Bonaventure129/inpatient-monitoring-system/image/block diagram.png

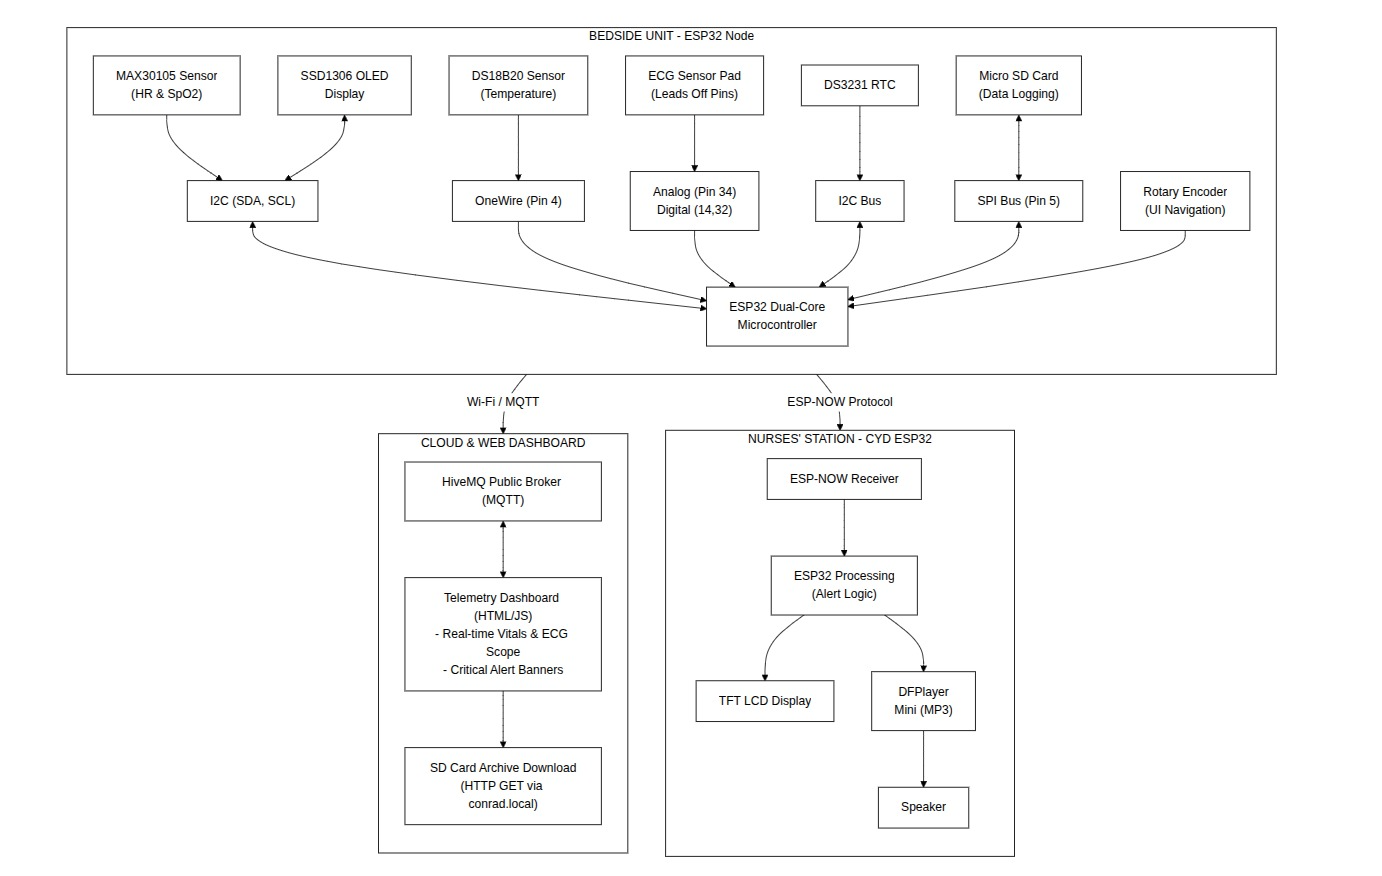
image/block diagram.png
