Bonaventure129/inpatient-monitoring-system/image/flowchart.png

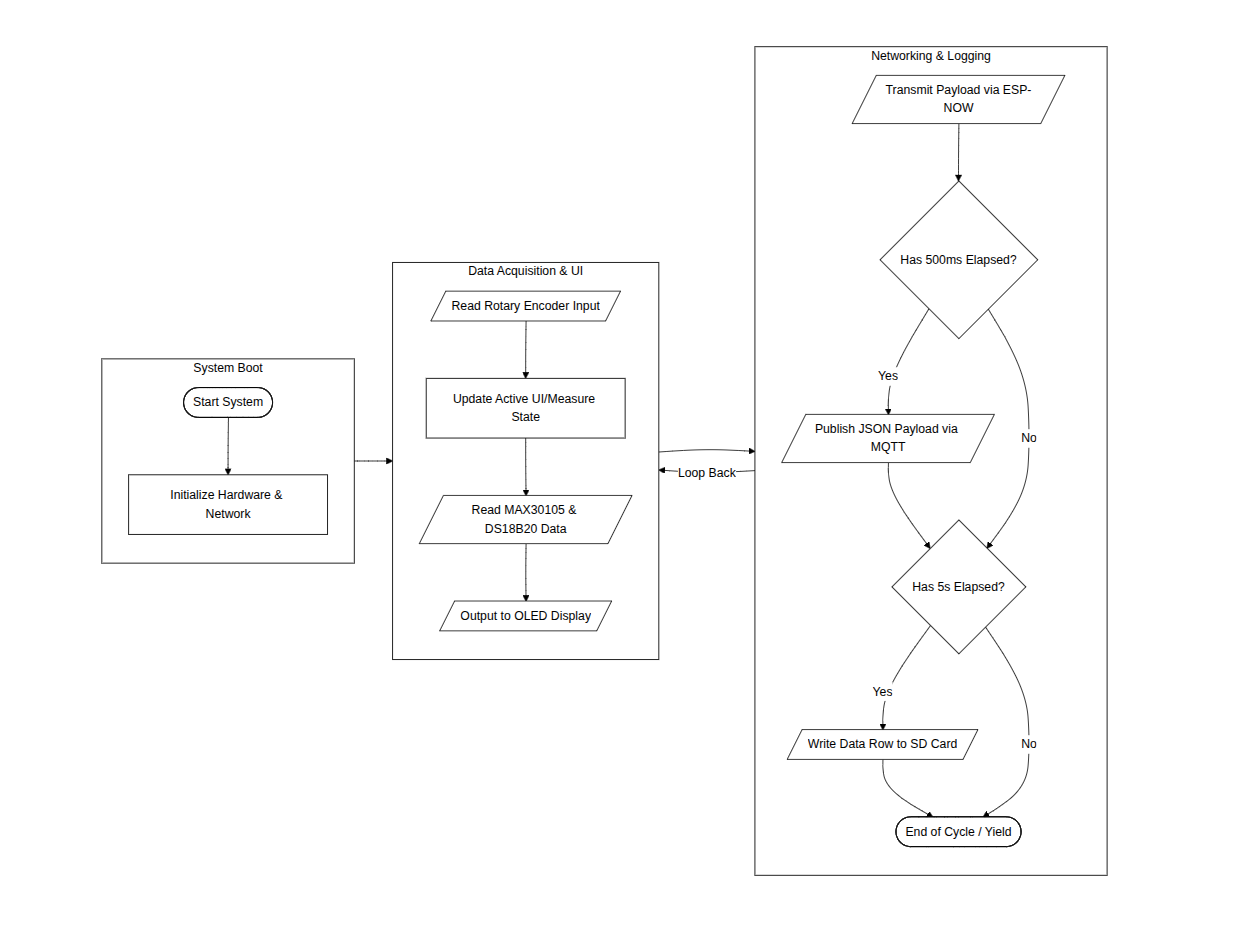
image/flowchart.png
