Bonaventure129/inpatient-monitoring-system/image/Schematic_Inpatient-monitoring-system-schematics_2026-08-19.png

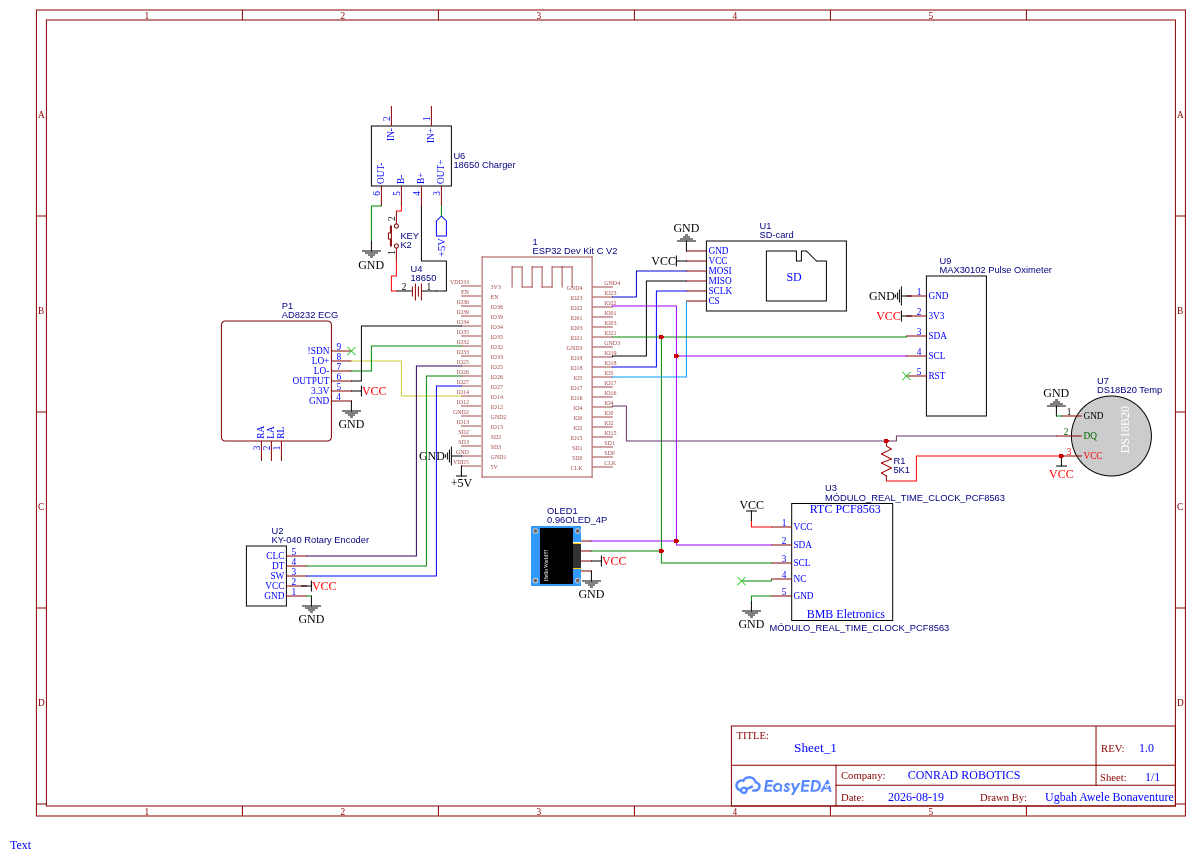
image/Schematic_Inpatient-monitoring-system-schematics_2026-08-19.png
