Bonaventure129/inpatient-monitoring-system/image/patient ward Inpatient -monitoring system schematics.pdf

SD

### GND

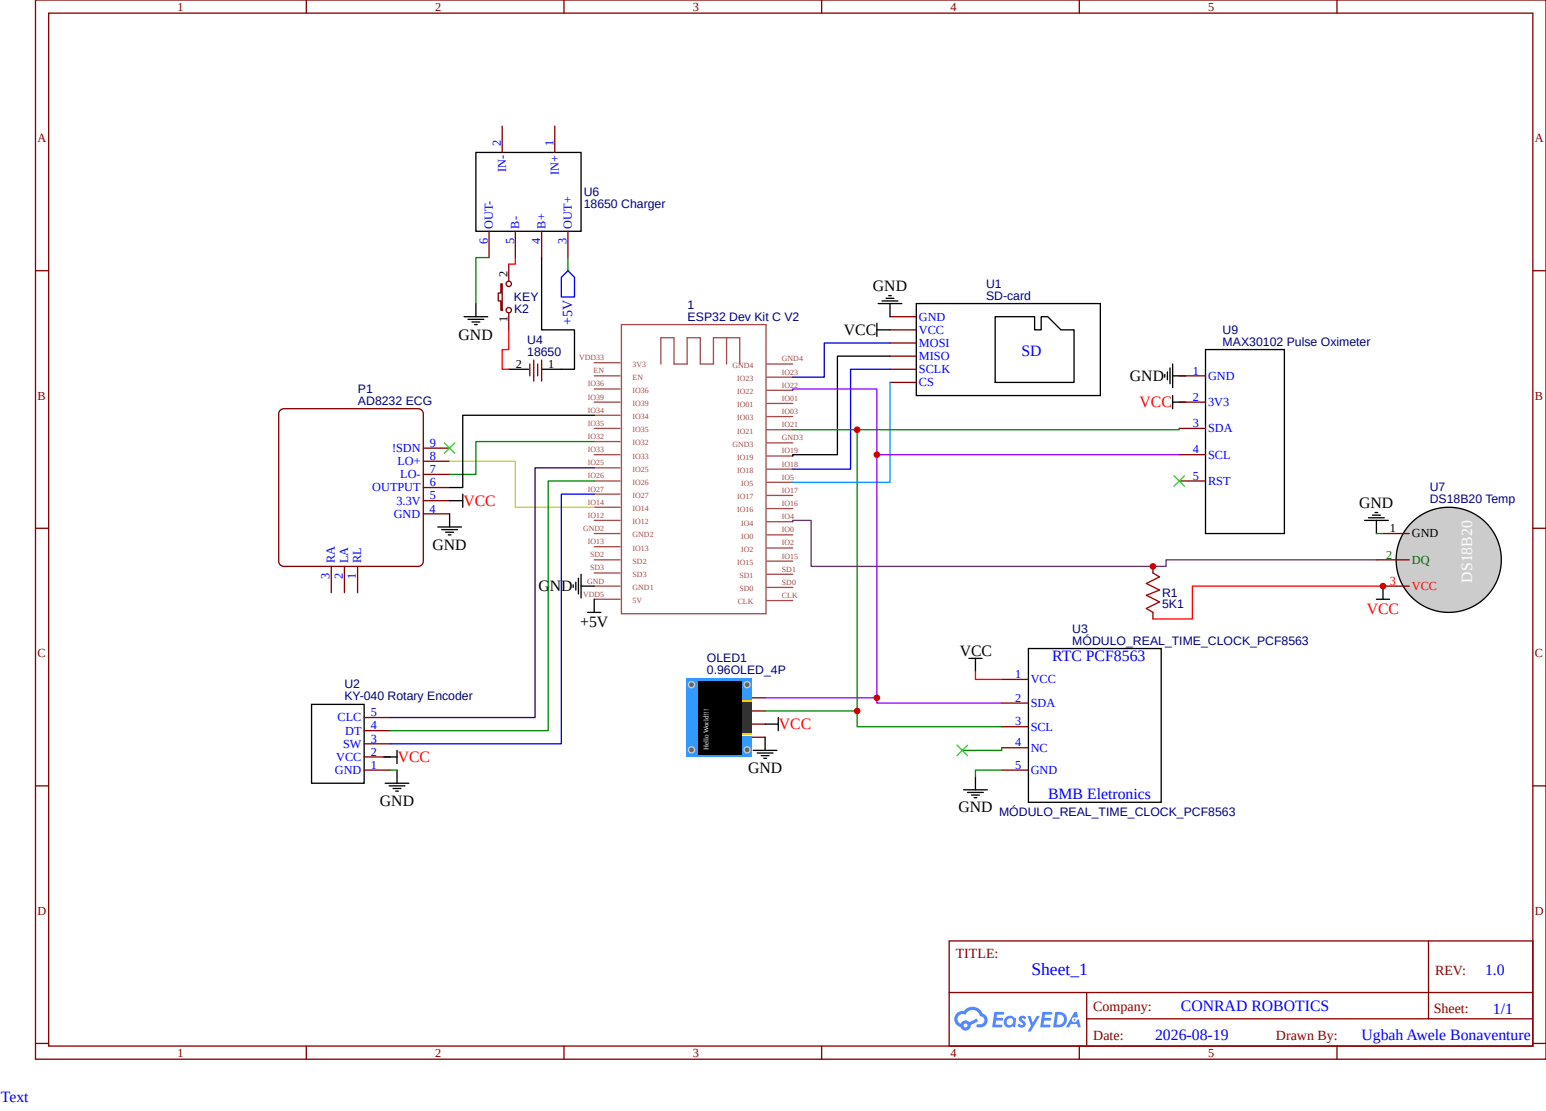
[picture p4: page 1]
